Ygbzyem/AI-Keyword-Spotting-With-ESP32/ml/edge-impulse-model/README.md

# Exported Edge Impulse library

| Item | Value |
|---|---|
| Library name | `AI_Speech_to_text_inferencing` |
| Library version | 1.0.127 |
| Options | Arduino library, EON Compiler, Quantized (int8) |
| Release asset | `AI_Keyword_Spotting.zip` (5.4 MB) on the GitHub Release `v1.0.0` |
| SHA-256 | `da983ef3d0fb10bf447a990d3dea4550b7966481228b3b1b0fa1c0e01ba6326b` |

Check the download with `sha256sum AI_Keyword_Spotting.zip` (Linux/macOS) or `certutil -hashfile AI_Keyword_Spotting.zip SHA256` (Windows).

Put the Arduino library `.zip` from Edge Impulse (Deployment: Arduino library, EON Compiler, int8) in this folder and install it with `arduino-cli lib install --zip-path`. The `.zip` is git-ignored; attach it to a GitHub Release if you want to publish the exact model.
