Ygbzyem/AI-Keyword-Spotting-With-ESP32/docs/images/05-dataset-labels.png

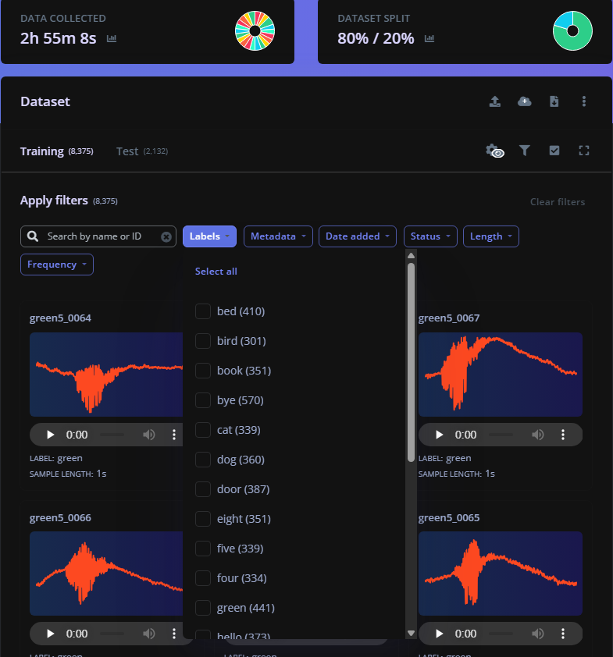
docs/images/05-dataset-labels.png
