Ygbzyem/AI-Keyword-Spotting-With-ESP32/docs/images/07-nn-training-settings.png

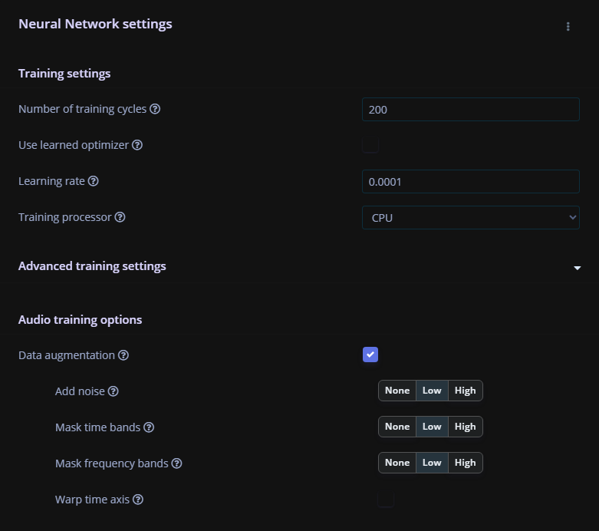
docs/images/07-nn-training-settings.png
