Ygbzyem/AI-Keyword-Spotting-With-ESP32/docs/images/09-quantization-deployment.png

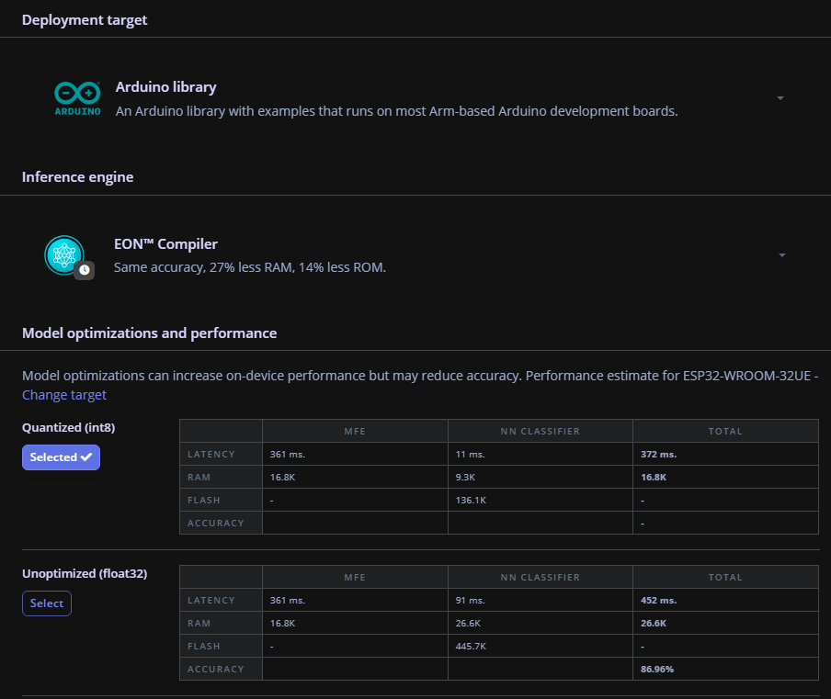
docs/images/09-quantization-deployment.png
