Ygbzyem/AI-Keyword-Spotting-With-ESP32/docs/images/10-demo-standby.jpg

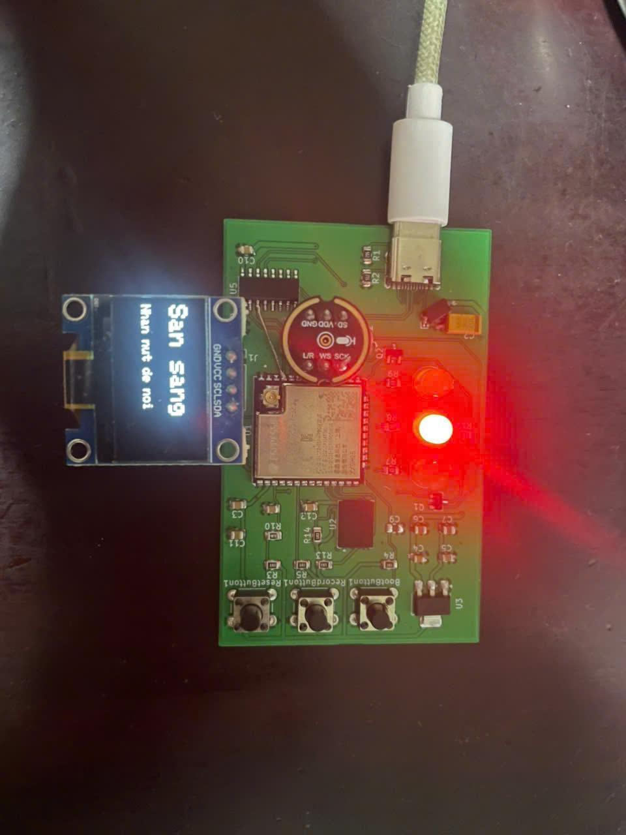
docs/images/10-demo-standby.jpg
