Ygbzyem/AI-Keyword-Spotting-With-ESP32/docs/images/11-demo-recording.jpg

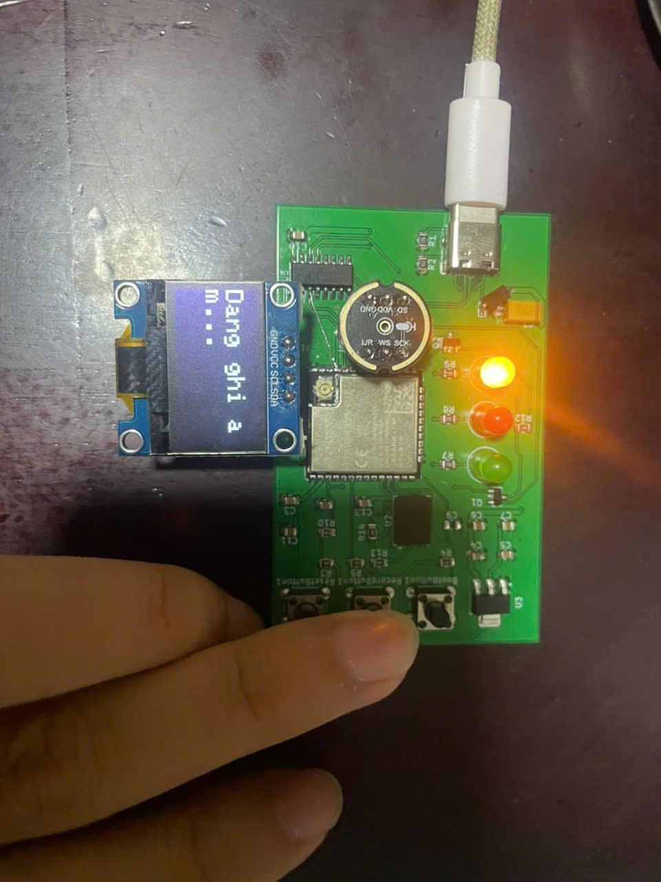
docs/images/11-demo-recording.jpg
