Ygbzyem/AI-Keyword-Spotting-With-ESP32/docs/images/12-demo-result.jpg

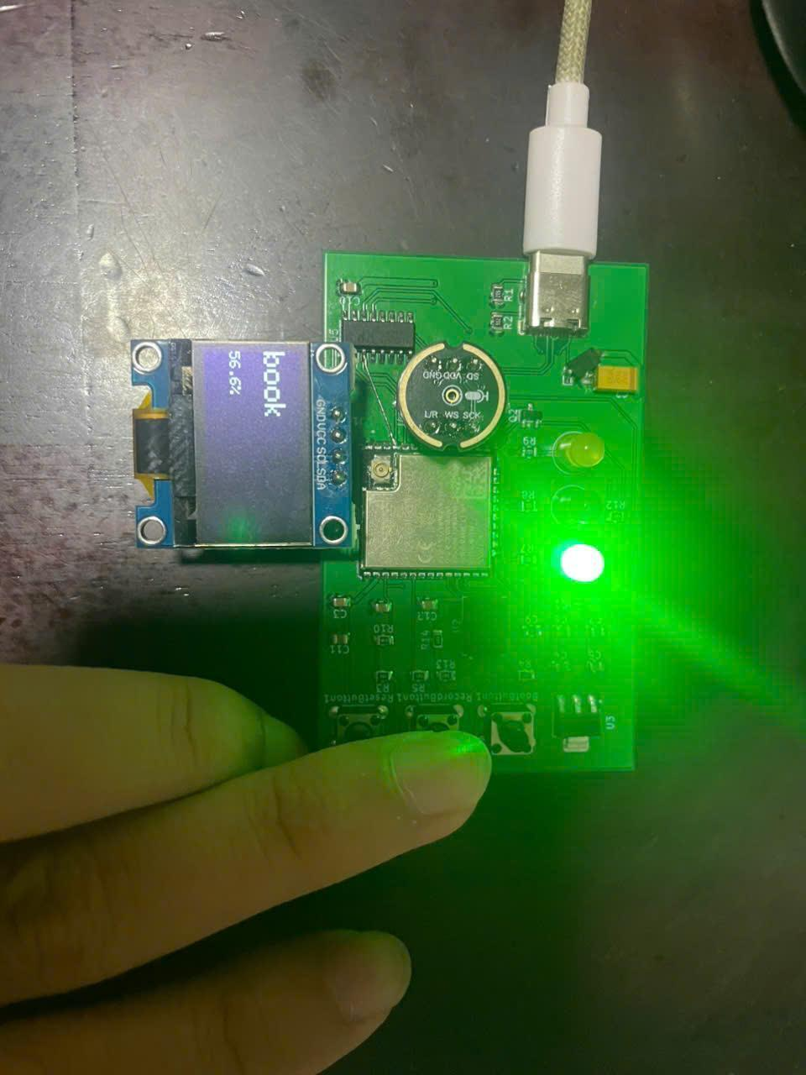
docs/images/12-demo-result.jpg
