Ygbzyem/AI-Keyword-Spotting-With-ESP32/hardware/pcb/AI_Keyword_Spotting.kicad_pcb

## KiCad design hardware/pcb/AI_Keyword_Spotting.kicad_pcb (2026-11-09)

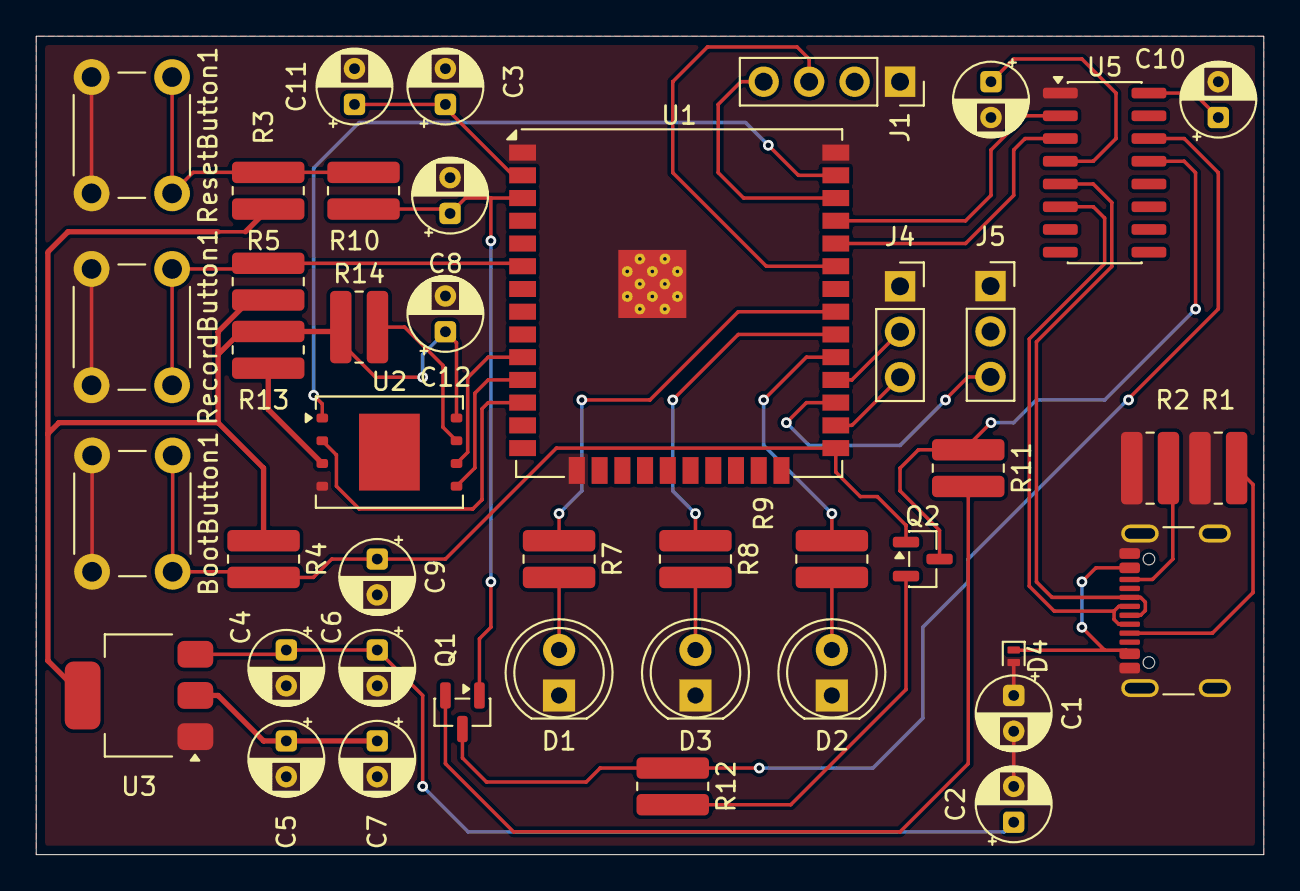
[picture p54: board AI_Keyword_Spotting.kicad_pcb from above]

Board: 2 copper layers, 68.6 x 45.7 mm, 43 parts (0 on the bottom side), 36 nets.

Parts:
BootButton1: SW_Push; SW_PUSH_6mm
C1, C2: 4u7; CP_Radial_D4.0mm_P2.00mm
C3, C8, C9, C10, C13: 0.1uF; CP_Radial_D4.0mm_P2.00mm
C4, C5, C12: 100nF; CP_Radial_D4.0mm_P2.00mm
C6, C7: 10uF; CP_Radial_D4.0mm_P2.00mm
C11: 22uF; CP_Radial_D4.0mm_P2.00mm
D1, D2, D3: LED; LED_D5.0mm
D4: PESD5V0L1UL; D_SOD-882
J1: OLED; PinSocket_1x04_P2.54mm_Vertical
J2: USB_C_Receptacle_USB2.0_14P; USB_C_Receptacle_GCT_USB4105-xx-A_16P_TopMnt_Horizontal
J4, J5: Conn_01x03_Pin; PinSocket_1x03_P2.54mm_Vertical
Q1, Q2: NPN; SOT-23
R1, R2: 5.1k; R_0815_2038Metric_Pad1.20x4.05mm_HandSolder
R3, R4, R5, R7, R8, R9, R10, R11, R12, R13, R14: 10k; R_0815_2038Metric_Pad1.20x4.05mm_HandSolder
RecordButton1: SW_Push; SW_PUSH_6mm
ResetButton1: SW_Push; SW_PUSH_6mm
U1: ESP32-WROOM-32UE
U2: W25Q128JVE; WSON-8-1EP_8x6mm_P1.27mm_EP3.4x4.3mm
U3: AMS1117-3.3; SOT-223-3_TabPin2
U5: CH340C; SOIC-16_3.9x9.9mm_P1.27mm

Connections:
+3.3V: C3.1, C5.1, C7.1, C10.1, C11.1, C12.1, J1.2, J5.2, R3.1, R4.1, R5.1, R13.1, R14.1, U1.2 (VDD), U2.8 (VCC), U3.2 (VO), U5.16 (VCC)
+5V: C2.1, C4.1, C6.1, U3.3 (VI)
/Boot: BootButton1.1, C9.1, Q2.1 (C), R4.2, U1.25 (IO0)
/CS: U1.37 (IO23), U2.1 (~CS)
/DATA+: J2.A6 (D+), J2.B6 (D+), U5.5 (UD+)
/DATA-: J2.A7 (D-), J2.B7 (D-), U5.6 (UD-)
/DTR: Q2.3 (E), R11.1, U5.13 (~DTR)
/Green: R7.1, U1.31 (IO19)
/MISO: U1.12 (IO27), U2.2 (DO/IO_{1})
/MOSI: U1.11 (IO26), U2.5 (DI/IO_{0})
/RTS: Q1.3 (E), R12.1, U5.14 (~RTS)
/RX: U1.34 (RXD0/IO3), U5.3 (RXD)
/Record: R5.2, RecordButton1.1, U1.6 (IO34)
/Red: R9.1, U1.29 (IO5)
/Reset: C8.1, Q1.1 (C), R10.2, U1.3 (EN)
/SCK_F: U1.10 (IO25), U2.6 (CLK)
/SCK_M: J4.3, U1.26 (IO4)
/SCL: J1.3, U1.33 (IO21)
/SD: J5.3, U1.27 (IO16)
/SDA: J1.4, U1.36 (IO22)
/TX: U1.35 (TXD0/IO1), U5.2 (TXD)
/WS: J4.2, U1.28 (IO17)
/Yellow: R8.1, U1.30 (IO18)
GND: BootButton1.2, C1.1, C1.2, C2.2, C3.2, C4.2, C5.2, C6.2, C7.2, C8.2, C9.2, C10.2, C11.2, C12.2, C13.2, D1.1 (K), D2.1 (K), D3.1 (K), D4.2 (A), J1.1, J2.A1 (GND), J2.A12 (GND), J2.B1 (GND), J2.B12 (GND), J2.S1 (SHIELD), J4.1, J5.1, R1.2, R2.2, RecordButton1.2, ResetButton1.2, U1.1 (GND), U1.15 (GND), U1.38 (GND), U1.39 (GND), U2.4 (GND), U3.1 (GND), U5.1 (GND)
unnamed: D1.2 (A), R7.2
unnamed: D2.2 (A), R8.2
unnamed: D3.2 (A), R9.2
unnamed: D4.1 (K), J2.A4 (VBUS), J2.A9 (VBUS), J2.B4 (VBUS), J2.B9 (VBUS)
unnamed: J2.A5 (CC1), R1.1
unnamed: J2.B5 (CC2), R2.1
unnamed: Q1.2 (B), R11.2
unnamed: Q2.2 (B), R12.2
unnamed: R3.2, R10.1, ResetButton1.1
unnamed: R14.2, U2.7 (~HOLD/~RESET/IO_{3})
unnamed: R13.2, U2.3 (~WP/IO_{2})
unnamed: C13.1, U5.4 (V3)
