Ygbzyem/AI-Keyword-Spotting-With-ESP32/(commit log)

2026-11-09 Initial commit: AI Keyword Spotting with ESP32
    [AI_Keyword_Spotting.kicad_pcb, AI_Keyword_Spotting.kicad_sch]
2026-11-09 fix(tools): name clips <label>.<index>.wav so Edge Impulse infers the label
    [capture_audio.py, dataset_capture.ino, kws_inference.ino]
